annoyedmilk/Business-Card/hardware/BOM.csv

No. | Quantity | Comment | Designator | Footprint | Value | Manufacturer Part | Manufacturer | Supplier Part | Supplier
1 | 1 | 3034TR | BAT1 | BAT-SMD_3034TR |  | 3034TR | Keystone | C5213768 | LCSC
2 | 2 | 1uF | C1,C3 | C0805 | 1uF | GRM21BR71E105KA99L | muRata(村田) | C77080 | LCSC
3 | 1 | 100nF | C2 | C0805 | 100nF | CC0805KRX7R9BB104 | YAGEO(国巨) | C49678 | LCSC
4 | 1 | 10uF | C4 | C0805 | 10uF | GRM21BR61C106KE15L | muRata(村田) | C77075 | LCSC
5 | 1 | 4.7uF | C5 | C0805 | 4.7uF | GRM21BR61E475KA12L | muRata(村田) | C77077 | LCSC
6 | 1 | 2.2uF | C6 | C0805 | 2.2uF | GRM21BR71E225KE11L | muRata(村田) | C77081 | LCSC
7 | 1 | X096-2864KSWAG01-H30 | DS1 | LCD-SMD_X096-2864KSWAG01-H30 |  | X096-2864KSWAG01-H30 | Newvision(新智景) | C5123563 | LCSC
8 | 1 | 4kHz | LS1 | BUZ-SMD_3P-L5.2-W5.2-P3.50-BR | 4kHz | MLT-5030 | 华能 | C95297 | LCSC
9 | 1 | X6511FRS-03-C85D30 | P1 | HDR-SMD_3P-P2.54-H-F-L11.5 |  | X6511FRS-03-C85D30 | XKB Connectivity(中国星坤) | C5142236 | LCSC
10 | 1 | 22Ω | R1 | R0805 | 22Ω | RC0805FR-0722RL | YAGEO(国巨) | C107702 | LCSC
11 | 3 | 3.9kΩ | R2,R3,R6 | R0805 | 3.9kΩ | RC0805FR-073K9L | YAGEO(国巨) | C114221 | LCSC
12 | 2 | 20kΩ | R4,R8 | R0805 | 20kΩ | RC0805FR-0720KL | YAGEO(国巨) | C114566 | LCSC
13 | 1 | 8.2kΩ | R5 | R0805 | 8.2kΩ | RC0805FR-078K2L | YAGEO(国巨) | C114545 | LCSC
14 | 1 | 620kΩ | R7 | R0805 | 620kΩ | RC0805FR-07620KL | YAGEO(国巨) | C185284 | LCSC
15 | 2 | 2kΩ | R9,R10 | R0805 | 2kΩ | RC0805FR-072KL | YAGEO(国巨) | C114572 | LCSC
16 | 1 | SK-3296S-01-L1 | SW1 | SW-SMD_3P-P1.50_L2.7-W6.6 |  | SK-3296S-01-L1 | XKB Connectivity(中国星坤) | C319020 | LCSC
17 | 5 | TS110926045 | SW2,SW3,SW4,SW5,SW6 | SW-SMD_4P-L4.5-W4.5-P3.00-LS6.6 |  | TS110926045 | HanElectricity(瀚源) | C22375351 | LCSC
18 | 1 | CH32V003J4M6 | U1 | SOP-8_L4.9-W3.8-P1.27-LS6.0-BL |  | CH32V003J4M6 | WCH(南京沁恒) | C5346354 | LCSC
