annoyedmilk/Business-Card/hardware/3D.step

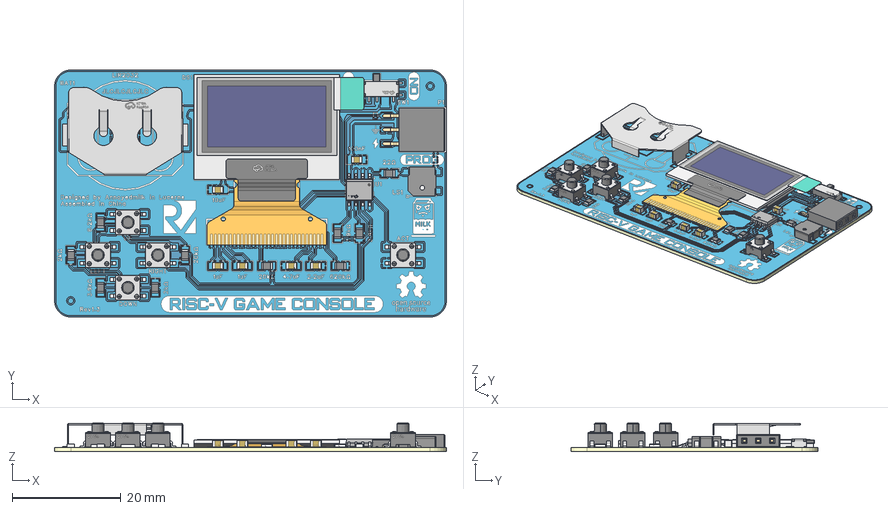
[picture p4: CAD file, 2025-09-11]
hardware/3D.step
72.0 x 45.4 x 5.27 mm
Board~lMyq
TopCopper~lMyq
BottomCopper~lMyq
TopSilkscreen~lMyq
BottomSilkscreen~lMyq
TopFpcStiffener~lMyq
BottomFpcStiffener~lMyq
BAT-SMD_3034TR~BAT-SMD_3034TR~lMyq
R0805~R0805_L2.0-W1.3-H0.6~lMyq x 10
BUZ-SMD_3P-L5.2-W5.2-P3.50-BR~BUZ-SMD_3P-L5.2-W5.2-H2.0-P3.50~lMyq
HDR-SMD_3P-P2.54-H-F-L11.5~HDR-SMD_3P-P2.54-H-F-L11.5~lMyq
C0805~C0805_L2.0-W1.3-H1.3~lMyq x 6
SW-SMD_3P-P1.50_L2.7-W6.6~SW-SMD_3P-L6.6-W2.7-LS7.8-P1.50~lMyq
SOP-8_L4.9-W3.8-P1.27-LS6.0-BL~SOP-8_L4.9-W3.8-P1.27-LS6.0-BL~lMyq
LCD-SMD_X096-2864KSWAG01-H30~LCD-SMD_X096-2864KSWAG01-H30~lMyq
SW-SMD_4P-L4.5-W4.5-P3.00-LS6.6~SW-SMD_4P-L4.5-W4.5-P3.00-LS6.6~lMyq x 5
