annoyedmilk/Business-Card/hardware/Schematic.pdf

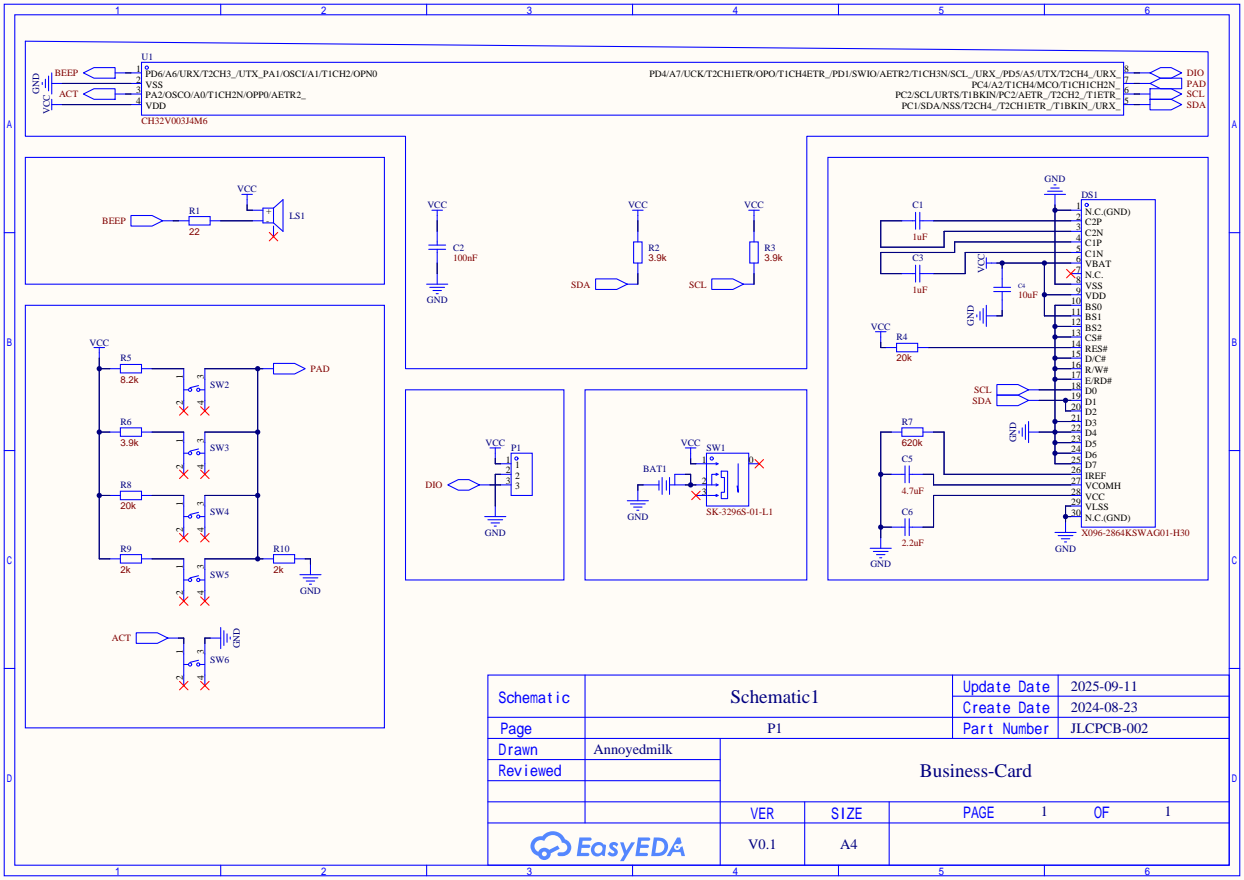
[picture p6: page 1]

PD4/A7/UCK/T2CH1ETR/OPO/T1CH4ETR_/PD1/SWIO/AETR2/T1CH3N/SCL_/URX_/PD5/A5/UTX/T2CH4_/URX_ 8
