annoyedmilk/Business-Card/(list of files, drawings)

Other design files:
hardware/ProPrj_Business-Card.epro
