annoyedmilk/Business-Card/software/src/spritebank.c

//         >>>>>  T-I-N-Y  T-R-I-S v3 for ATTINY85  GPL v3 <<<<<
//                     Programmer: Daniel C 2019-2021
//              Contact EMAIL: electro_l.i.b@tinyjoypad.com
//                      https://WWW.TINYJOYPAD.COM
//           https://sites.google.com/view/arduino-collection

//          >>>>>  T-I-N-Y  P-A-C-M-A-N for ATTINY85  GPL v3 <<<<
//                   Programmer: Daniel C 2018-2021
//             Contact EMAIL: electro_l.i.b@tinyjoypad.com
//           https://sites.google.com/view/arduino-collection

//  Tiny-tris and Tiny-pacman are free software: you can redistribute it and/or modify
//  it under the terms of the GNU General Public License as published by
//  the Free Software Foundation, either version 3 of the License, or
//  (at your option) any later version.

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
// ===================================================================================
// Modified to work with CH32V003 by Stefan Wagner: https://github.com/wagiminator
// Modified to include both Tiny Tris and Tiny Pacman by annoyedmilk: https://github.com/annoyedmilk
// ===================================================================================

#include "spritebank.h"

// Hand-packed image data below: fixed layouts chosen so each table reads as the
// picture it encodes. Leave the formatter out of it.
// clang-format off

// =================== TETRIS ===================
const uint8_t H_Grid_TTTRIS[] = {
    0, 0, 0, 1, 1, 1, 2, 2, 2, 3, 3, 3, 4, 4, 4, 5, 5, 5, 6, 6, 6, 7,
    7, 7, 8, 8, 8, 9, 9, 9, 10, 10, 10, 11, 11, 11, 12, 12, 12};

const uint8_t Pieces_TTRIS[] = {
    // 0
    0b00000000,
    0b00100000,
    0b01110000,
    0b00000000,
    0b00000000,
    // 1
    0b00000000,
    0b00000000,
    0b00110000,
    0b00110000,
    0b00000000,
    // 2
    0b00000000,
    0b00000000,
    0b00110000,
    0b01100000,
    0b00000000,
    // 3
    0b00000000,
    0b00010000,
    0b00110000,
    0b00100000,
    0b00000000,
    // 4
    0b00100000,
    0b00100000,
    0b00100000,
    0b00100000,
    0b00000000,
    // 5
    0b00000000,
    0b00100000,
    0b00100000,
    0b01100000,
    0b00000000,
    // 6
    0b00000000,
    0b00100000,
    0b00100000,
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

const uint8_t tiny_PREVIEW_block_TTTRIS[] = {
    2, 1,
    0b11000000,
    0b11000000};

const uint8_t tinyblock_TTTRIS[] = {
    3, 1,
    0x07, 0x05, 0x07};

const uint8_t tinyblock2_TTTRIS[] = {
    3, 1,
    0b11100000,
    0b11100000,
    0b11100000};

const uint8_t police_TTRIS[] = {
    4, 1,
    0x1F, 0x11, 0x1F, 0x00,
    0x00, 0x1F, 0x00, 0x00,
    0x1D, 0x15, 0x17, 0x00,
    0x11, 0x15, 0x1F, 0x00,
    0x07, 0x04, 0x1F, 0x00,
    0x17, 0x15, 0x1D, 0x00,
    0x1F, 0x15, 0x1D, 0x00,
    0x01, 0x1D, 0x03, 0x00,
    0x1F, 0x15, 0x1F, 0x00,
    0x17, 0x15, 0x1F, 0x00};

const uint8_t start_button_1_TTRIS[] = {
    30, 1,
    0xFE, 0x01, 0x01, 0x01, 0x01, 0x01, 0x01, 0x01, 0x01, 0x01, 0x01, 0x01, 0x01, 0x01, 0x01, 0x01, 0x01, 0x01, 0x01, 0x01,
    0x01, 0x01, 0x01, 0x01, 0x01, 0x01, 0x01, 0x01, 0x01, 0xFE};

const uint8_t start_button_2_TTRIS[] = {
    30, 1,
    0x03, 0x04, 0x04, 0x04, 0x04, 0x04, 0x04, 0x04, 0x04, 0x04, 0x04, 0x04, 0x04, 0x04, 0x04, 0x04, 0x04, 0x04, 0x04, 0x04,
    0x04, 0x04, 0x04, 0x04, 0x04, 0x04, 0x04, 0x04, 0x04, 0x03};

const uint8_t chateau_TTRIS[] = {
    0xD5, 0xF8, 0xF4, 0xEA, 0x54, 0x7A, 0x55, 0x68, 0x74, 0x7A, 0x54, 0x6A, 0x55, 0x78, 0x74, 0x6A, 0x54, 0x7A, 0x55, 0x68,
    0x74, 0x7A, 0x54, 0x6A, 0x55, 0x78, 0x74, 0x6A, 0x54, 0x7A, 0x55, 0x68, 0xF4, 0xFA, 0xD4, 0xEA, 0xFF, 0x01, 0x00, 0x02,
    0x02, 0x82, 0xFE, 0x82, 0x02, 0x02, 0x88, 0xFA, 0x80, 0x00, 0xF8, 0x10, 0x08, 0x08, 0xF0, 0x00, 0x18, 0x60, 0xC0, 0x38,
    0x88, 0xA0, 0xA8, 0xA8, 0x28, 0x28, 0x28, 0x08, 0x08, 0x08, 0x01, 0xFF, 0xFF, 0x00, 0x04, 0x04, 0x04, 0x14, 0x14, 0x14,
    0x54, 0x54, 0x50, 0x50, 0x44, 0x04, 0x04, 0xFC, 0x04, 0x04, 0x04, 0xF0, 0x22, 0x12, 0x01, 0x10, 0xF4, 0x00, 0x00, 0x20,
    0x50, 0x50, 0x90, 0x00, 0x00, 0x00, 0x00, 0xFF, 0xFF, 0x00, 0x00, 0x00, 0x00, 0x80, 0x40, 0x40, 0x00, 0x40, 0x40, 0xC0,
    0x40, 0x40, 0x01, 0x81, 0x41, 0x40, 0x80, 0x01, 0x00, 0xC0, 0x40, 0x41, 0x81, 0x01, 0x40, 0x41, 0xC1, 0x41, 0x40, 0x00,
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
    0x48, 0x0B, 0x01, 0x05, 0x01, 0x06, 0x01, 0x03, 0x05, 0x00,
};

// Sprites are width, height, then one byte per column per row.
const uint8_t Joy[] = {
    0x05, 0x01, 0x0E, 0x1F, 0x1F, 0x1F, 0x0E,
};

const uint8_t boutton[] = {
    0x18, 0x03, 0x00, 0x00, 0x00, 0x00, 0xC0, 0xE0, 0xE0, 0xF0, 0xF0, 0xF8, 0xF8, 0xF8, 0xF8, 0xF8,
    0xF8, 0xF0, 0xF0, 0xE0, 0xE0, 0xC0, 0x00, 0x00, 0x00, 0x00, 0x00, 0x00, 0x00, 0x7F, 0xFF, 0xFF,
    0xFF, 0xFF, 0xFF, 0xFF, 0xFF, 0xFF, 0xFF, 0xFF, 0xFF, 0xFF, 0xFF, 0x7F, 0x1F, 0xCF, 0x7F, 0x00,
    0x00, 0x00, 0x00, 0x00, 0x00, 0x00, 0x01, 0x03, 0x03, 0x07, 0x07, 0x0F, 0x0F, 0x0F, 0x0F, 0x0F,
    0x0D, 0x05, 0x06, 0x02, 0x03, 0x01, 0x00, 0x00, 0x00, 0x00,
};
// clang-format on
