annoyedmilk/Business-Card/(commit log)

2024-12-04 Update files
    [BOM.xlsx]
2025-01-09 add power measurements
2025-09-11 Polish project and clean up repository
    Polish project documentation and clean up repository structure
    - Updated README with comprehensive project overview and current file structure
    - Enhanced power measurement documentation with professional formatting
    - Added detailed component specifications and part numbers from BOM
    - Included battery life estimations and voltage range analysis
    - Corrected build instructions and firmware installation paths
    - Added both front and back PCB renders to documentation
    - Improved project structure documentation with file descriptions
2025-09-11 Add photo of finished business card PCB
    Added Business-Card.jpg to the documentation and updated README.md to showcase the finished PCB in action.
2026-08-06 Switch firmware to ch32fun, add test mode and persistent high scores
    - Replace PlatformIO with the ch32fun submodule and a plain Makefile
    - Run core at 24 MHz with fixed frame pacing, I2C bus at 1.2 MHz
    - Add TinyJoypad TESTMODE as a third menu entry for board bring-up
    - Store the Tiny Tris high score in the last flash page, reserved
    by the linker script
    - Compress menu font, logo and Pacman bitmaps to fit everything in 16K
    - Remove dead ATtiny EEPROM code and stale power measurement docs
2026-08-06 Fix I2C setup and drop driver code superseded by ch32fun
    The display stayed dark: the I2C wait loops had no timeout, so an
    unresponsive panel hung the firmware before the first frame. Follow
    ch32fun's ssd1306_i2c setup instead, which is known to drive this panel
    from a CH32V003: reset the peripheral before configuring it, check the
    combined STAR1/STAR2 event codes, enable ACK, and bound every wait.
    Bus rate drops to 1 MHz, ch32fun's default for these panels, which also
    divides exactly at 24 MHz where 1.2 MHz truncated the divisor.
    Also removes the parts of the wagiminator drivers that ch32fun now
    covers or that nothing calls: the unused I2C pin remap variants, the
    OLED commands and helpers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
2026-08-06 Remove dead code left over from the ATtiny ports
    The linker was discarding these, so they cost nothing in the image, but
    they still had to be read and maintained.
    - Merge SplitSpriteDecalageY_TTRIS into SplitSpriteDecalageY. The two
    were semantically identical, which is why GCC folded them into one
    symbol; the shared helper now has a neutral name.
    - Drop 'add', a global that was written once and never read.
    - Drop PIN_SCL and PIN_SDA, unused since i2c_tx.c configures those pins
    itself, and a redundant spritebank.h include in main.c.
    Verified with --gc-sections and inlining disabled, so a discarded
    section means genuinely uncalled rather than merely inlined. Nothing of
    ours is discard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
2026-08-06 Run at 12 MHz, send pixels by DMA, blank the panel when idle
    Battery work. The panel draws far more than the MCU, and the core was
    spinning through most of every frame.
    - Halve the core clock to 12 MHz. Game speed is unaffected, frame_sync()
    pins it, and the I2C rate still divides exactly.
    - Send pixel data over DMA1 channel 6 and sleep through the transfer
    rather than spinning on TXE. The games are untouched: a page is
    gathered in a buffer behind the JOY_OLED_send macro.
    - Sleep instead of spinning in the frame pacing, via a shared sleep_us().
    - Set the panel drive level, which was left at the controller default.
    - Blank the panel after 30 s idle in the menu, waking on any button.
    -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
2026-08-06 Revert to the 24 MHz build without DMA
    The 12 MHz and DMA changes made the games feel sluggish. Most likely the
    clock: halving it doubles Pacman's compute, and its frame was already
    close to the 24 ms budget, so the pacing stops holding it and it free
    runs slower than intended.
    Reverts the firmware to the last configuration verified on hardware and
    brings the README back in step with it. The reverted work is kept on the
    power-experiments branch: DMA transfers, sleeping instead of spinning,
    panel contrast, idle blanking, hold-to-exit and the menu spacing fixes.
2026-08-10 Split the firmware into modules and cut per-pixel work
    main.c had grown to 2300 lines holding both games, and driver.h was a
    second source file behind a header's name: it defined JOY_sound(),
    JOY_random(), map(), the menu, the font and the startup logo, and only
    linked because exactly one translation unit included it.
    - Split into main, tetris, pacman, testmode, ui, input, sprite, timing
    and spritebank. Per-game globals are now static, and spritebank is
    data with a header of externs rather than definitions in a header.
    - Move the sprite blitter out of Tetris. It was blitzSprite_TTRIS but
    pulled a helper out of Pacman and was called from test mode, so it is
    now sprite.c with neutral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
